mstump/iot_demo_hardware_v2/README.md

iot_demo_hardware_v2
====================
