mstump/iot_demo_hardware_v2/iot_inventory_mote/iot_inventory_mote.brd

## EAGLE design iot_inventory_mote/iot_inventory_mote.brd (2014-08-19)

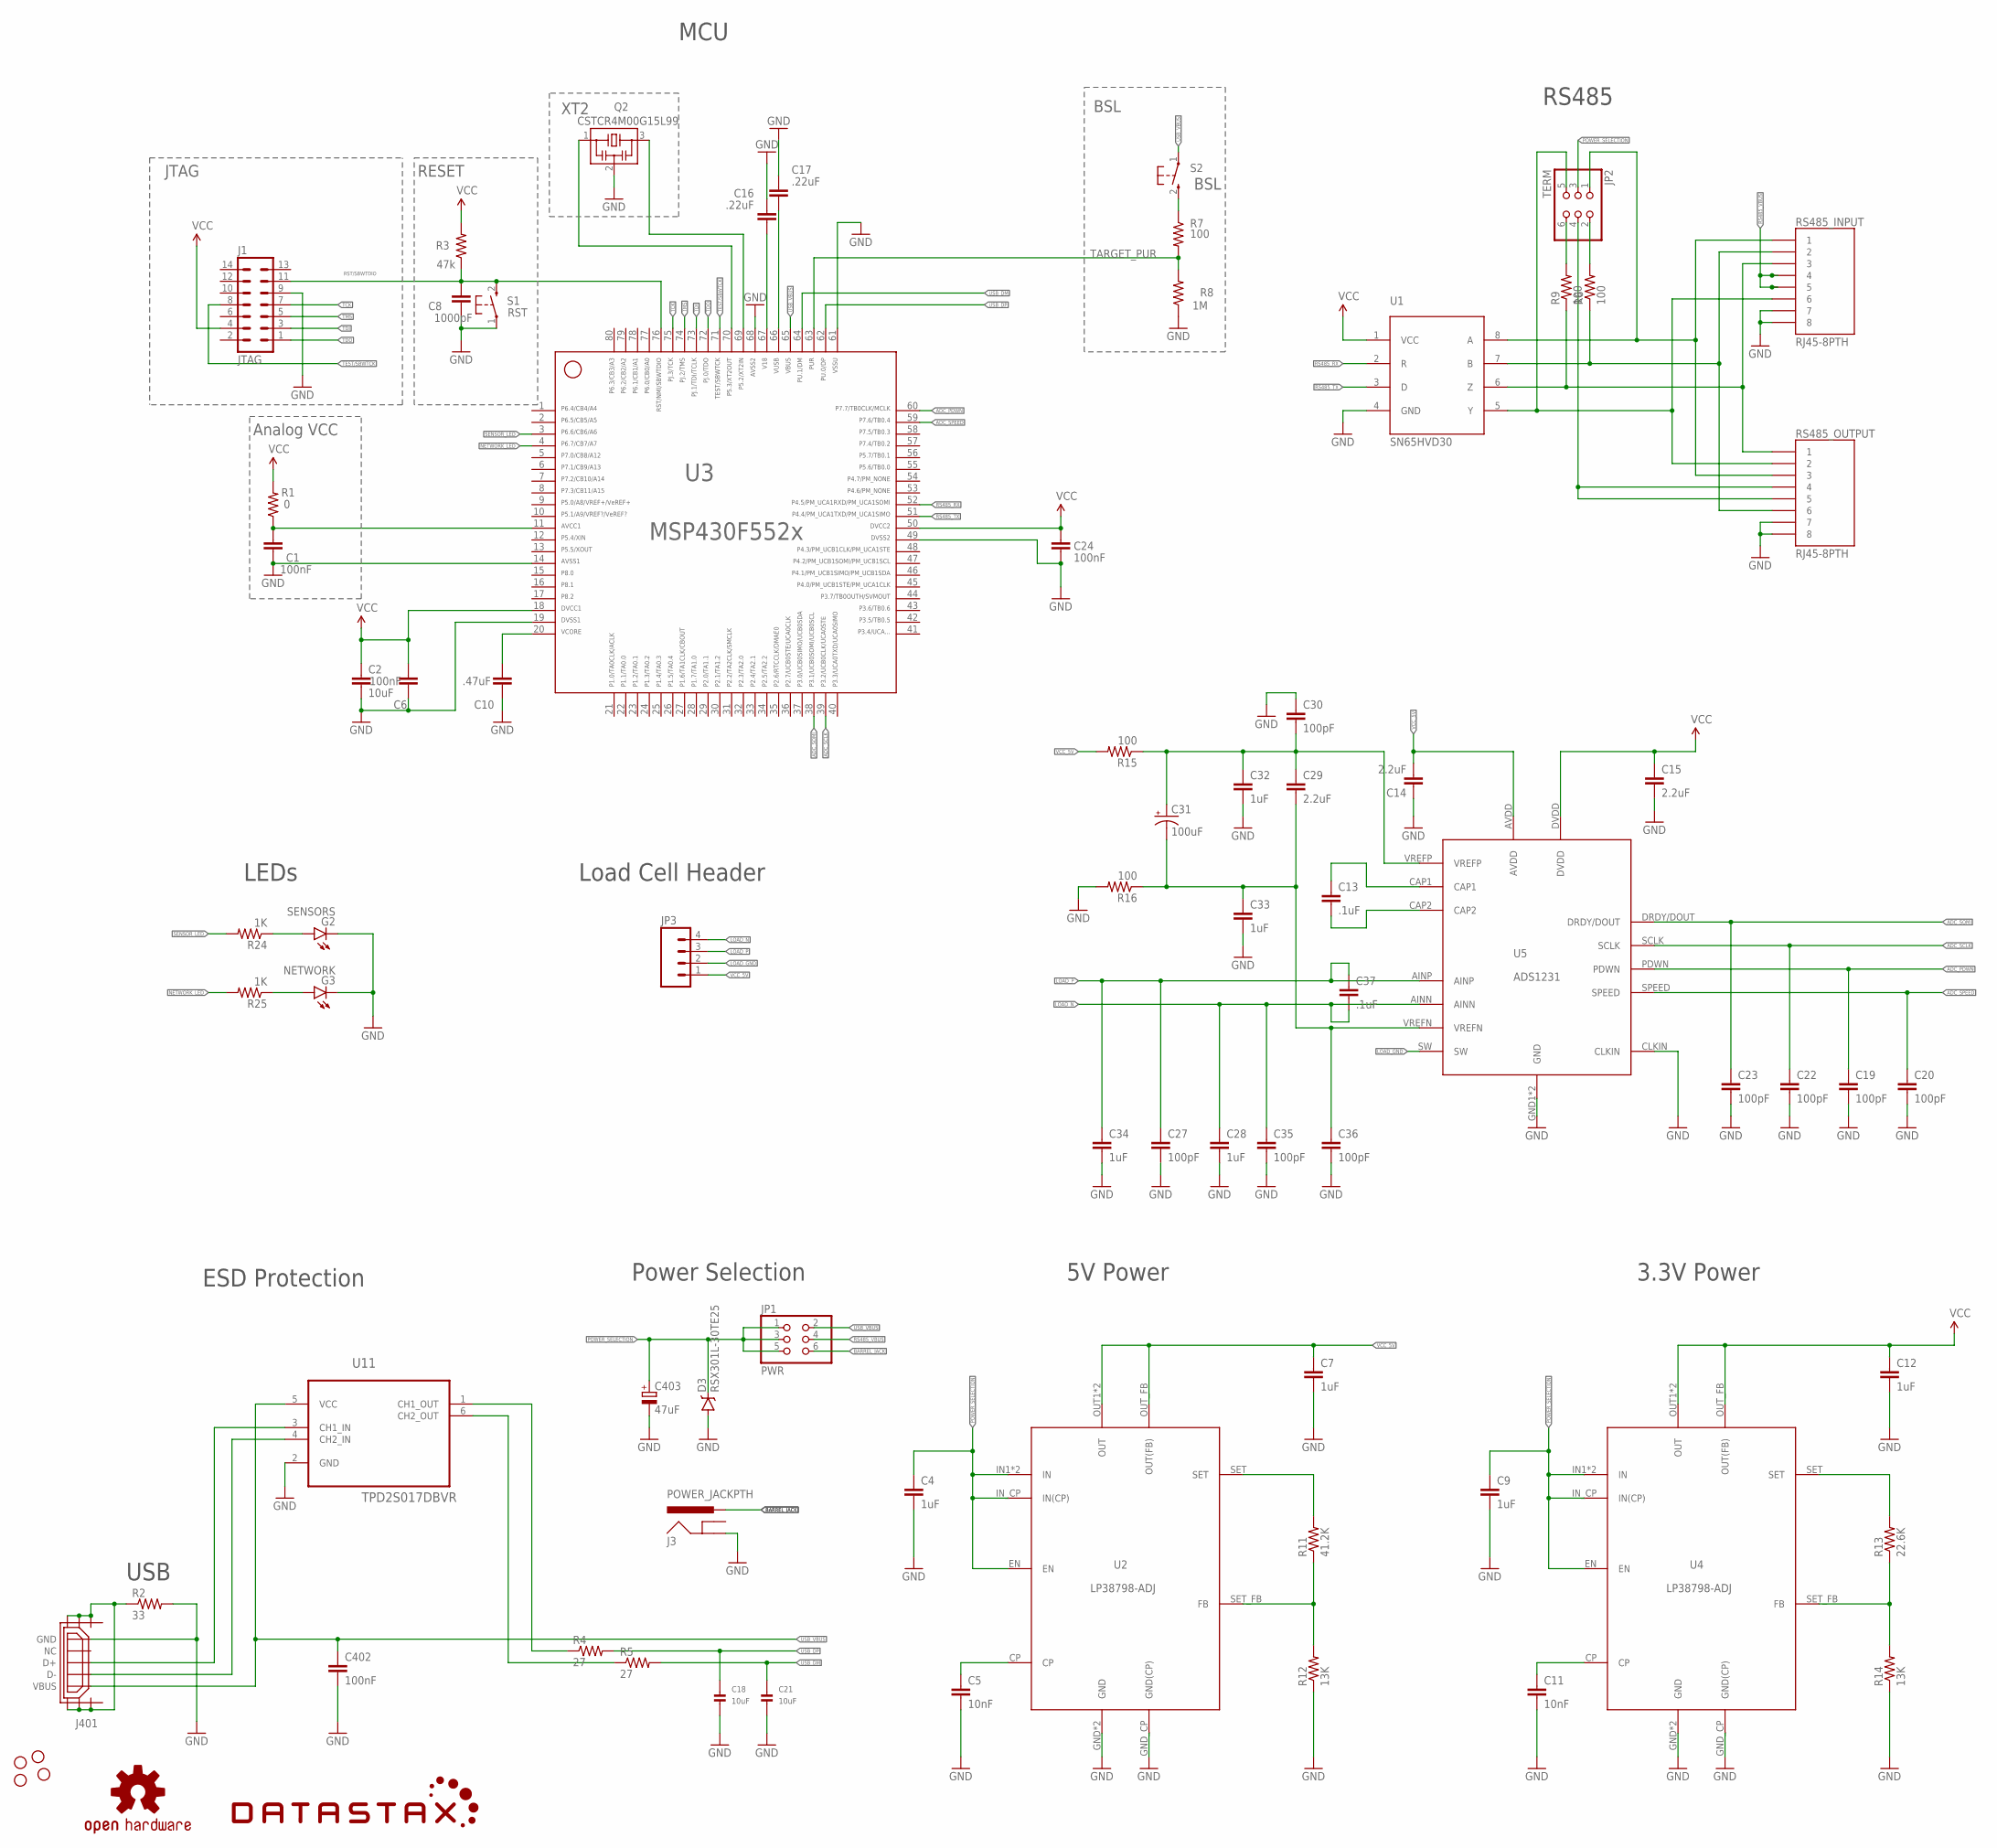
[picture p1: schematic iot_inventory_mote.sch, sheet 1]

Parts:
C1, C6, C24: 100nF; 0402-CAP
C2: 10uF; 0402-CAP
C4, C7, C9, C12: 1uF; 0402-CAP
C5, C11: 10nF; 0402-CAP
C8: 1000pF; 0402-CAP; MPN C1005X7R1H102K050BA
C10: .47uF; 0402-CAP
C13, C37: .1uF; 1210
C14, C15, C29: 2.2uF; 0402-CAP
C16, C17: .22uF; 0402-CAP
C18, C21: 10uF; 0603; MPN 06035A100FAT2A
C19, C20, C22, C23: 100pF; 0805
C27, C30, C35, C36: 100pF; 0603-CAP
C28, C32, C33, C34: 1uF; 0805
C31: 100uF; EIA7343
C402: 100nF; 0402-CAP; MPN 100NA100MEFC12.5X25
C403: 47uF; A/3216-18R
D3: RSX301L-30TE25; SMA-DIODE
G2: SENSORS; LED-0603
G3: NETWORK; LED-0603
J1: JTAG; ML14; MPN SBH11-PBPC-D07-ST-BK
J3: POWER_JACKPTH; POWER_JACK_PTH
J401: USB_MICRO_FLIPPED; HIROSE-ZX62R-B-5P; MPN ZX62R-B-5P
JP1: PWR; 2X03
JP2: TERM; 2X03
JP3: M04SCREW; SCREWTERMINAL-3.5MM-4
LOGO1: OSHW-LOGOL; OSHW-LOGO-L
Q2: CSTCR4M00G15L99; MURATA-FILTER_CSTCR
R1: 0; R0402
R2: 33; 0402-RES
R3: 47k; R0402; MPN ERJ-2RKF4702X
R4, R5: 27; 0402-RES
R6, R9, R15, R16: 100; 0402-RES
R7: 100; R0402
R8: 1M; R0402
R11: 41.2K; 0402-RES
R12, R14: 13K; 0402-RES
R13: 22.6K; 0402-RES
R24, R25: 1K; 0402-RES; MPN ERJ-2RKF1001X
RS485_INPUT, RS485_OUTPUT: RJ45-8PTH; RJ45-8; MPN 54602-908LF
S1: RST; PBTH; MPN EVQ-11L05R
S2: BSL; PBTH
STANDOFF1, STANDOFF2, STANDOFF3, STANDOFF4: STAND-OFF
U1: SN65HVD30; SOIC8; MPN SN65HVD3082EDR
U2, U4: LP38798-ADJ; WSON12; MPN LP38798SD-ADJ/NOPB
U3: MSP430F5529IPNR; PN80; MPN MSP430F5529IPNR
U5: ADS1231; MPN ADS1231ID
U11: TPD2S017DBVR; SOT95P280X145-6N
U$1: DATASTAX_LOGO

Connections:
ADC_PDWN: C19.1, U3.60, U5.PDWN
ADC_SCLK: C22.1, U3.39, U5.SCLK
ADC_SOMI: C23.1, U3.38, U5.DRDY/DOUT
ADC_SPEED: C20.1, U3.59, U5.SPEED
AVCC: C1.1, R1.1, U3.11
BARREL_JACK: J3.PWR, JP1.6
GND: C1.2, C2.2, C4.2, C5.2, C6.2, C7.2, C8.2, C9.2, C10.2, C11.2, C12.2, C14.1, C15.2, C16.2, C17.2, C18.2, C19.2, C20.2, C21.2, C22.2, C23.2, C24.2, C27.2, C28.2, C30.1, C32.2, C33.2, C34.2, C35.2, C36.2, C402.2, C403.-, D3.A, G2.C, G3.C, J1.9, J3.GND, J401.GND, Q2.2, R2.2, R8.1, R12.1, R14.1, R16.2, RS485_INPUT.7, RS485_INPUT.8, RS485_OUTPUT.7, RS485_OUTPUT.8, S1.1, U1.4 (GND), U2.GND, U2.GND_CP (GND(CP)), U2.GPAD (GND), U3.14, U3.19, U3.49, U3.61, U3.68, U4.GND, U4.GND_CP (GND(CP)), U4.GPAD (GND), U5.CLKIN, U5.GND1 (GND), U5.GND2 (GND), U11.2 (GND)
LOAD_GND: JP3.2, U5.SW
LOAD_N: C28.1, C35.1, C37.2, JP3.4, U5.AINN
LOAD_P: C27.1, C34.1, C37.1, JP3.3, U5.AINP
unnamed: JP2.2, R6.2
unnamed: R6.1, RS485_INPUT.2, RS485_OUTPUT.6, U1.7 (B)
unnamed: R9.1, RS485_INPUT.3, RS485_OUTPUT.1, U1.6 (Z)
unnamed: JP2.1, RS485_INPUT.1, RS485_OUTPUT.3, U1.8 (A)
unnamed: G3.A, R25.1
unnamed: JP2.6, R9.2
unnamed: JP2.5, RS485_INPUT.6, RS485_OUTPUT.2, U1.5 (Y)
unnamed: R13.2, U4.SET
unnamed: J401.D+, U11.3 (CH1_IN)
unnamed: R11.1, R12.2, U2.SET_FB (FB)
unnamed: R11.2, U2.SET
unnamed: C5.1, U2.CP
unnamed: J401.D-, U11.4 (CH2_IN)
unnamed: R13.1, R14.2, U4.SET_FB (FB)
unnamed: C11.1, U4.CP
unnamed: C13.1, U5.CAP1
unnamed: C13.2, U5.CAP2
unnamed: G2.A, R24.1
unnamed: J401.SHIELD1, J401.SHIELD2, J401.SHIELD3, J401.SHIELD4, J401.SHIELD5, J401.SHIELD6, R2.1
unnamed: C29.1, C30.2, C31.A (+), C32.1, R15.1, U5.VREFP
unnamed: R7.1, S2.2 (S)
unnamed: R5.1, U11.6 (CH2_OUT)
unnamed: R4.1, U11.1 (CH1_OUT)
unnamed: C29.2, C31.C (-), C33.1, C36.1, R16.1, U5.VREFN
unnamed: JP2.4, RS485_OUTPUT.4, RS485_OUTPUT.5
NETWORK_LED: R25.2, U3.4
P5.2/XT2IN: Q2.3, U3.69
P5.3/XT2OUT: Q2.1, U3.70
POWER_SELECTION: C4.1, C9.1, C403.+, D3.C, JP1.1, JP1.3, JP1.5, JP2.3, U2.EN, U2.IN1 (IN), U2.IN2 (IN), U2.IN_CP (IN(CP)), U4.EN, U4.IN1 (IN), U4.IN2 (IN), U4.IN_CP (IN(CP))
RS485_RX: U1.2 (R), U3.52
RS485_TX: U1.3 (D), U3.51
RS485_VBUS: JP1.4, RS485_INPUT.4, RS485_INPUT.5
RST/SBWTDIO: C8.1, J1.11, R3.1, S1.2 (S), U3.76
SENSOR_LED: R24.2, U3.3
TARGET_PUR: R7.2, R8.2, U3.63
TARGET_VUSB: C17.1, U3.66
TCK: J1.7, U3.75
TDI: J1.3, U3.73
TDO: J1.1, U3.72
TEST/SBWTCK: J1.8, U3.71
TMS: J1.5, U3.74
USB_DM: C21.1, R5.2, U3.64
USB_DP: C18.1, R4.2, U3.62
USB_VBUS: C402.1, J401.VBUS, JP1.2, S2.1, U3.65, U11.5 (VCC)
V18: C16.1, U3.67
VCC: C2.1, C6.1, C12.1, C15.1, C24.1, J1.4, R1.2, R3.2, U1.1 (VCC), U3.18, U3.50, U4.OUT1 (OUT), U4.OUT2 (OUT), U4.OUT_FB (OUT(FB)), U5.DVDD
VCC_5V: C7.1, C14.2, JP3.1, R15.2, U2.OUT1 (OUT), U2.OUT2 (OUT), U2.OUT_FB (OUT(FB)), U5.AVDD
VCORE: C10.1, U3.20

Notes on the sheet:
USB
ESD Protection
RESET
XT2
BSL
Analog VCC
MCU
5V Power
JTAG
LEDs
RS485
3.3V Power
Power Selection
Load Cell Header

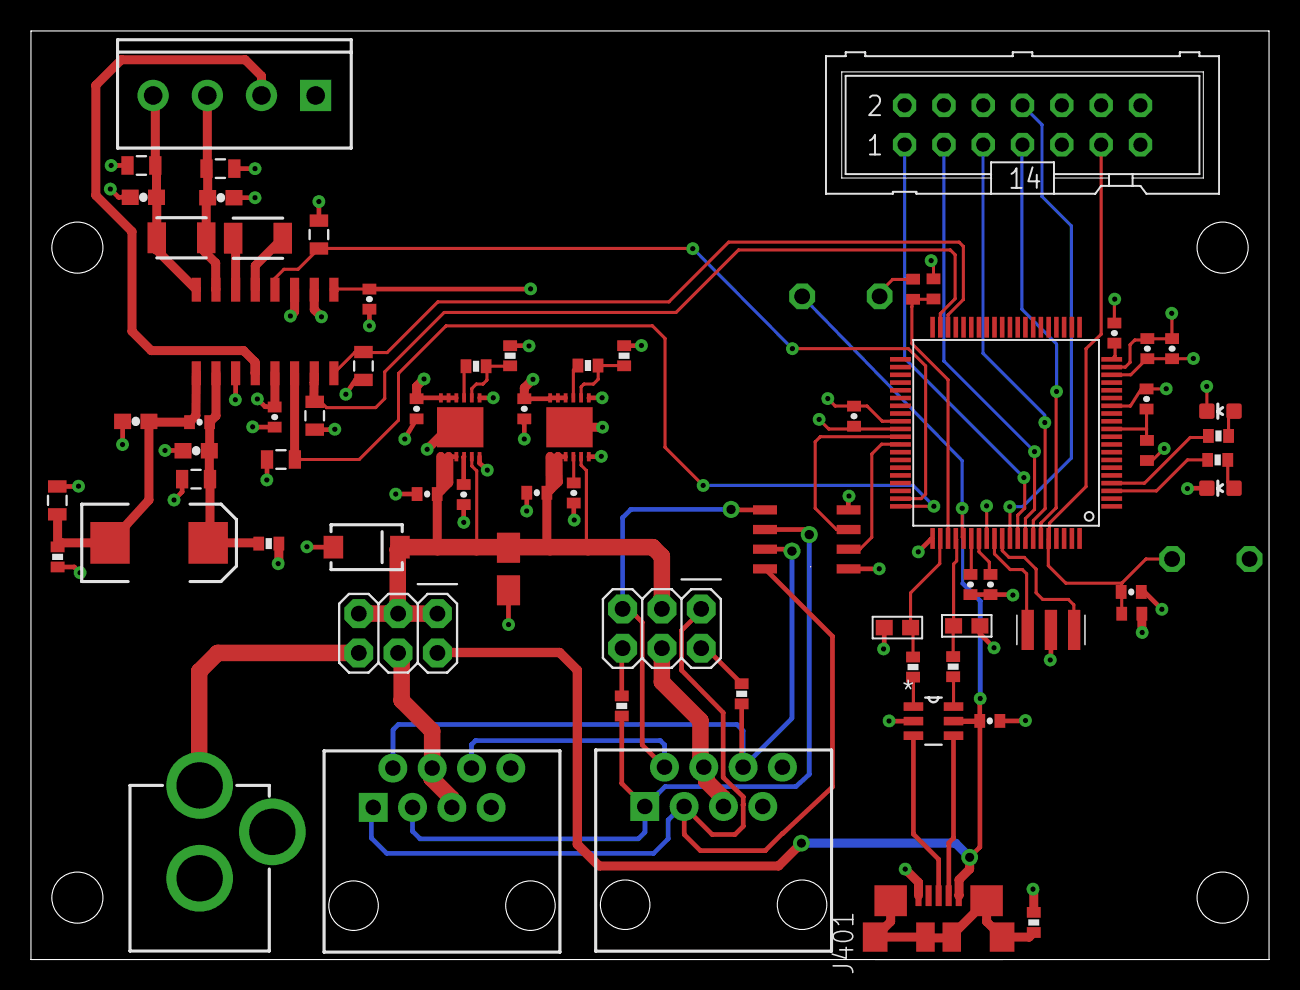
[picture p2: board iot_inventory_mote.brd from above]

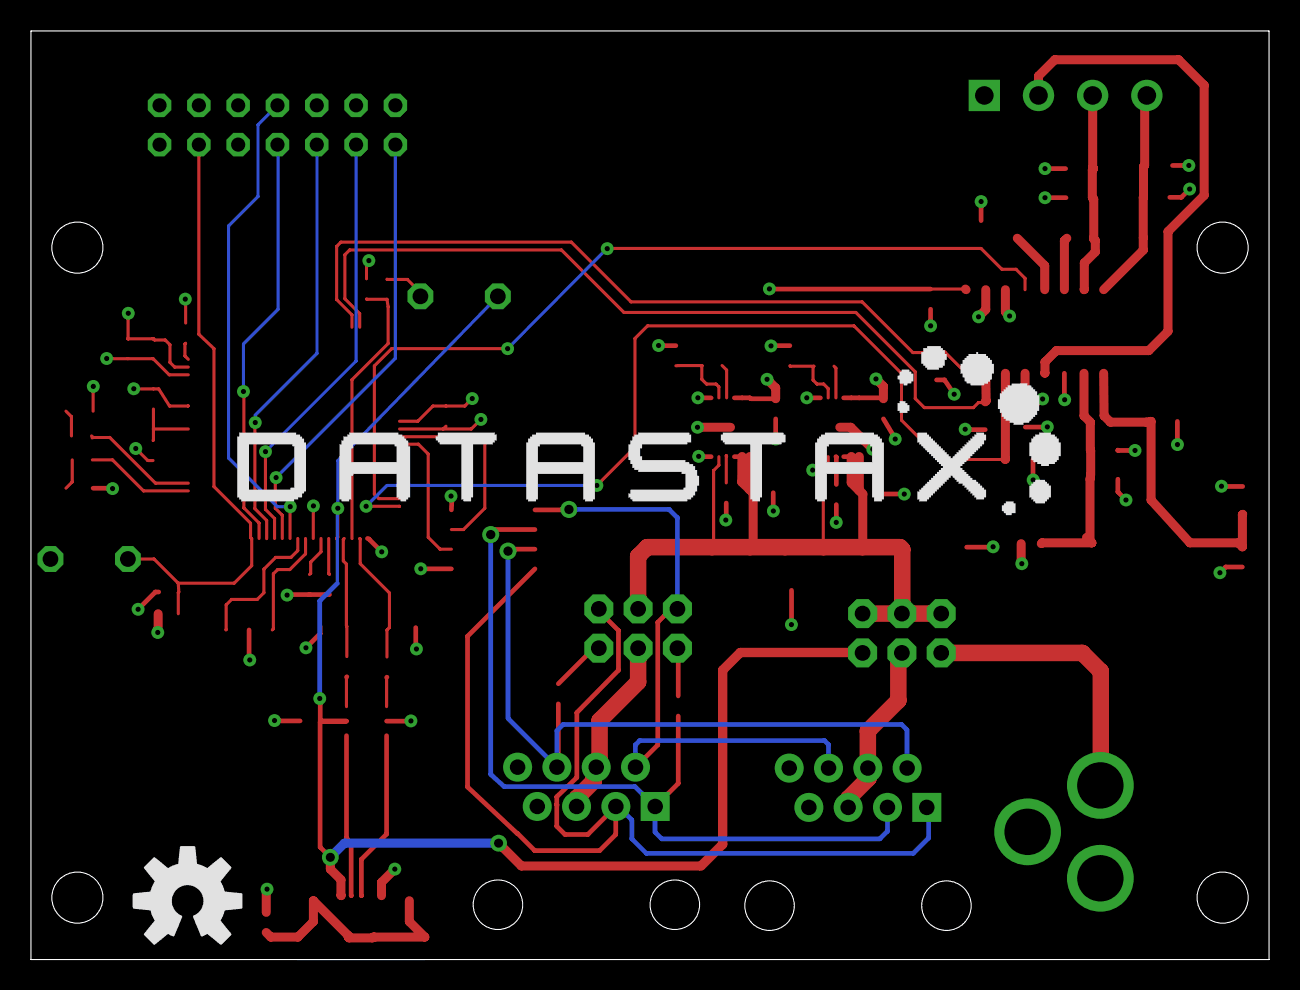
[picture p3: board iot_inventory_mote.brd from below]

Board: 4 copper layers, 80.0 x 60.0 mm, 79 parts (2 on the bottom side), 58 nets.
