mstump/iot_demo_hardware_v2/iot_env_mote/iot_env_mote.brd

## EAGLE design iot_env_mote/iot_env_mote.brd (2014-08-04)

Schematic: iot_env_mote.sch, sheet 1

Parts:
C1, C2, C6, C24: 100n; C0402
C3: 10u; A/3216-18R
C4, C12, C13: 10uF; 0805; MPN 06035A100FAT2A
C5: 2.2uF; 0805; MPN 06035A100FAT2A
C7, C11, C19, C31: 0.1uF; 0603; MPN 0603YC104JAT2A
C8: 1nF; C0402
C9, C18, C21: 10uF; 0603; MPN 06035A100FAT2A
C10: 470n; C0402
C16, C17: 220n; C0402
C22: 10uF; A/3216-18R
C23, C25: 1uF; 0603; MPN 06035A100FAT2A
C26, C27, C30, C33, C34, C38, C40, C42, C45, C48: 47nF; 0402-CAP; MPN 0603YC104JAT2A
C28, C32, C174: 15pF; 0402-CAP; MPN 0603YC104JAT2A
C29: 220nF; 0402-CAP; MPN 0603YC104JAT2A
C171: 10pF; 0402-CAP; MPN 0603YC104JAT2A
C172: 100pF; 0402-CAP; MPN 0603YC104JAT2A
C173: 33pF; 0402-CAP; MPN 0603YC104JAT2A
C175: 3pF; 0402-CAP; MPN 0603YC104JAT2A
C176: 1pF; 0402-CAP; MPN 0603YC104JAT2A
C181: 2.2pF; 0402-CAP; MPN 0603YC104JAT2A
C191, C201: 3.3pF; 0402-CAP; MPN 0603YC104JAT2A
C211: 10nF; 0402-CAP; MPN 0603YC104JAT2A
C221: 46nF; 0402-CAP; MPN 0603YC104JAT2A
C231: 1.5nF; 0402-CAP; MPN 0603YC104JAT2A
C402: 100nF; C0402
C403: 47uF; A/3216-18R
CHARGE: LED0603; LED-0603
CN1: USB; USB-MINIB
D8, D10: 0.01; R0402
D9: 1M; R0402
G1: SD/FLASH; LED-0603
G2: SENSORS; LED-0603
G3: NETWORK; LED-0603
J1: JTAG; ML14
J2: IO BREAKOUT; 2X10
J3: BATTERY; JST-PH-2-SMT-RA
JP2: MOTION; JST-3-PTH-VERT
L10: 4.7uH; SDR0403
L171: 10nH; C0402
L172: 7.5nH; C0402
L173: 18nH; C0402
L174, L192, L193, L201: 12nH; C0402
L191: 15nH; C0402
LOGO1: OSHW-LOGOL; OSHW-LOGO-L
POWER: LED0603; LED-0603
Q1: 32.768kHz; MS3V-T1R
Q2: CSTCR4M00G15L99; MURATA-FILTER_CSTCR
Q3: 40MHz; NX3225
Q4, Q5: BSS84; SOT23
R1: 0R; R0402
R2: 33k; 0402-RES
R3: 47k; R0402
R4, R5: 27; 0402-RES
R6, R27: 1K; R0402
R7: 100R; R0402
R8: 1M; R0402
R9, R18, R19, R20, R21, R23: 10K; R0402; MPN ERJ-P03F1002V
R10, R24, R25: 1K; 0402-RES
R12: 56k; 0402-RES
R16: 332K; R0402
R17: 649K; R0402
R26: 1.87K; R0402
R171: 10; 0402-RES
R181: 0; 0402-RES
S1: RST; PBTH
S2: BSL; PBTH
S3: DPDT; AYZ0202
SMA: SMA_EDGE; SMA-EDGE
U1: LTC3553-2; QFN-20-0.4MM
U2: MPL3115A2LGA8; LGA8; MPN MPL3115A2
U3: MSP430F5529IPNR; PN80
U4: HTU21DSMD; HTU21D; MPN HTU21D
U5: USD-SOCKETNEW; MICRO-SD-SOCKET-PP
U6: BQ27411; VSON40P400X400X12
U7: TSL2561FN; FN-6; MPN TSL2561T
U8: CC1200; RHB32
U11: TPD2S017DBVR; SOT95P280X145-6N
U$1: DATASTAX_LOGO

Connections:
AVCC: C1.1, R1.1, U3.11
BQ27411_BAT: C25.2, D8.2, J3.1 (2), U6.BAT, U6.SRP
FLASH_CD: U3.30, U5.CD1 (SHIELD)
FLASH_CSN: U3.29, U5.2 (CS)
FLASH_ENABLE: Q5.1 (G), U3.17
GND: C1.2, C2.1, C3.-, C4.2, C5.2, C6.1, C7.2, C8.2, C9.2, C10.1, C11.2, C13.2, C16.2, C17.2, C18.2, C19.2, C21.2, C22.-, C23.2, C24.2, C25.1, C26.2, C27.2, C28.2, C29.2, C30.2, C31.2, C32.2, C33.2, C34.2, C38.2, C40.2, C42.2, C45.2, C48.2, C171.2, C172.2, C175.2, C201.2, C211.2, C402.2, C403.-, D9.2, D10.2, J1.9, J2.2, J3.2 (1), JP2.1, L192.2, Q1.P3 (GND), Q2.2, Q3.2 (G2), Q3.4 (G1), R2.2, R8.1, R10.1, R12.2, R17.2, R24.1, R25.1, R26.1, R27.1, S1.1, SMA.GND@0 (GND), SMA.GND@1 (GND), SMA.GND@2 (GND), SMA.GND@3 (GND), U1.2 (SEQ), U1.5 (LDO_ON), U1.6 (STBY), U1.15 (NTC), U1.19 (SUSP), U1.21 (GND_PAD), U2.3 (GND), U3.14, U3.19, U3.49, U3.61, U3.68, U4.7 (GND), U4.GND, U5.6 (GND), U5.GND1 (SHIELD), U5.GND3 (SHIELD), U6.GND (TPAD), U6.VSS, U7.2 (ADDR), U7.3 (GND), U8.TP (33), U11.2 (GND)
I2C_SCL: J2.4, R18.1, R21.1, U2.8 (SCL), U3.47, U4.SCK, U6.SCL, U7.4 (SCL)
I2C_SDA: J2.6, R19.1, R20.1, U2.7 (SDA), U3.46, U4.DATA, U6.SDA, U7.6 (SDA)
IO_LED: G1.A, U3.26
IO_SCK: U3.36, U5.5 (SCK)
IO_SIMO: U3.40, U5.3 (DI)
IO_SOMI: U3.41, U5.7 (DO)
JTAG_SENSE: J1.4, S3.5
JTAG_VCC: J1.2, S3.3
LDO: U1.10 (LDO)
LDO_FB: U1.9 (LDO_FB)
LIGHT_INT: R9.1, U3.58, U7.5 (INT)
MOTION_ENABLE: Q4.1 (G), U3.59
MOTION_INT: JP2.2, U3.60
unnamed: C11.1, U2.2 (CAP)
unnamed: JP2.3, Q4.2 (S)
unnamed: C174.1, L171.1, U8.17
unnamed: Q5.2 (S), U5.4 (VCC), U5.8 (RSV)
unnamed: C231.2, U8.23
unnamed: CN1.D+, U11.3 (CH1_IN)
unnamed: C23.1, U6.VDD
unnamed: D10.1, U6.TEST
unnamed: C231.1, U8.24
unnamed: CN1.D-, U11.4 (CH2_IN)
unnamed: D9.1, U6.PROG
unnamed: C211.1, U8.21
unnamed: C174.2, C176.1, L172.1
unnamed: C29.1, U8.6
unnamed: C176.2, C181.2, L172.2, L173.1
unnamed: L174.2, R181.1
unnamed: C181.1, L193.2, U8.18
unnamed: C221.2, U8.22
unnamed: R181.2, SMA.SIG (SIGNAL)
unnamed: C175.1, L173.2, L174.1
unnamed: CN1.GND, R2.1
unnamed: C173.2, L171.2, R171.1
unnamed: C28.1, Q3.1 (X1), U8.30
unnamed: C191.1, L191.1, L192.1, U8.19
unnamed: C201.1, L191.2, L201.1, U8.20
unnamed: C32.1, Q3.3 (X2), U8.31
unnamed: G1.C, R10.2
unnamed: C191.2, L193.1, L201.2
unnamed: L10.2, U1.13 (SW)
unnamed: R12.1, U8.14
unnamed: R7.1, S2.2 (S)
unnamed: G2.C, R24.2
unnamed: G3.C, R25.2
unnamed: R5.1, U11.6 (CH2_OUT)
unnamed: R4.1, U11.1 (CH1_OUT)
unnamed: CHARGE.C, R6.1
unnamed: C4.1, C5.1, CHARGE.A, POWER.A, U1.12 (BVIN), U1.18 (VOUT)
unnamed: R6.2, U1.14 (CHRG)
unnamed: POWER.C, R27.2
unnamed: C12.2, R16.1, R17.1, U1.8 (BUCK_FB)
unnamed: R26.2, U1.16 (PROG)
P1.0: J2.20, U3.21
P1.1: J2.17, U3.22
P1.2: J2.18, U3.23
P1.3: J2.15, U3.24
P1.4: J2.16, U3.25
P2.2: J2.13, U3.31
P2.3: J2.14, U3.32
P2.4: J2.11, U3.33
P2.5: J2.12, U3.34
P2.6: J2.9, U3.35
P5.2/XT2IN: Q2.3, U3.69
P5.3/XT2OUT: Q2.1, U3.70
P5.4/XIN: Q1.P2 (2), U3.12
P5.5/XOUT: Q1.P1 (1), U3.13
PRESSURE_INT: R23.1, U2.6 (INT1), U3.43
REGULATOR_BUCK_ON: U1.7 (BUCK_ON), U3.2
REGULATOR_HPWR: U1.1 (HPWR), U3.1
REGULATOR_VCC: C12.1, C13.1, L10.1, R16.2, S3.1, S3.4
RF_CLK: U3.39, U8.8
RF_CSN: U3.53, U8.11
RF_GPIO0: U3.54, U8.10
RF_GPIO2: U3.55, U8.4
RF_GPIO3: U3.56, U8.3
RF_LED: G3.A, U3.28
RF_RESET: U3.57, U8.2
RF_SIMO: U3.37, U8.7
RF_SOMI: U3.38, U8.9
RST/SBWTDIO: C8.1, J1.11, R3.1, S1.2 (S), U3.76
SENSOR_LED: G2.A, U3.27
TARGET_PUR: R7.2, R8.2, U3.63
TARGET_VUSB: C17.1, U3.66
TCK: J1.7, U3.75
TDI: J1.3, U3.73
TDO: J1.1, U3.72
TEST/SBWTCK: J1.8, U3.71
TMS: J1.5, U3.74
UCA1_CLK: J2.10, U3.45
UCA1_RXD: J2.3, U3.52
UCA1_STE: J2.8, U3.48
UCA1_TXD: J2.5, U3.51
USB_DM: C21.1, R5.2, U3.64
USB_DP: C18.1, R4.2, U3.62
USB_VBUS: C402.1, C403.+, CN1.VBUS, J2.19, S2.1, U1.20 (VBUS), U3.65, U11.5 (VCC)
V18: C16.1, U3.67
VBAT+: D8.1, U1.17 (BAT), U6.SRN
VCC: C2.2, C3.+, C6.2, C7.1, C9.1, C19.1, C22.+, C24.1, C26.1, C27.1, C30.1, C31.1, C33.1, C34.1, C38.1, C40.1, C42.1, C45.1, C48.1, C171.1, C172.1, C173.1, C221.1, J2.1, Q4.3 (D), Q5.3 (D), R1.2, R3.2, R9.2, R18.2, R19.2, R20.2, R21.2, R23.2, R171.2, S3.2, U2.1 (VDD), U2.4 (VDDIO), U3.18, U3.50, U4.VDD, U7.1 (VDD), U8.1, U8.5, U8.12, U8.13, U8.15, U8.25, U8.26, U8.27, U8.28, U8.29
VCORE: C10.2, U3.20
VINLDO: U1.11 (VINLDO)

Notes on the sheet:
Humidity
Pressure
Sensors
I2C address is 0x40 I2C write is 0x80 I2C read is 0x81
I2C address is 0x60 I2C write is 0xC0 I2C read is 0xC1
Light
I2C address is 0x41
Battery Charger / Regulator
Battery Gauge
USB
ESD Protection
Radio
RESET
LFXTCLK
XT2
BSL
Analog VCC
MCU
Power Selection
JTAG
IO Breakout
MicroSD Flash
LEDs

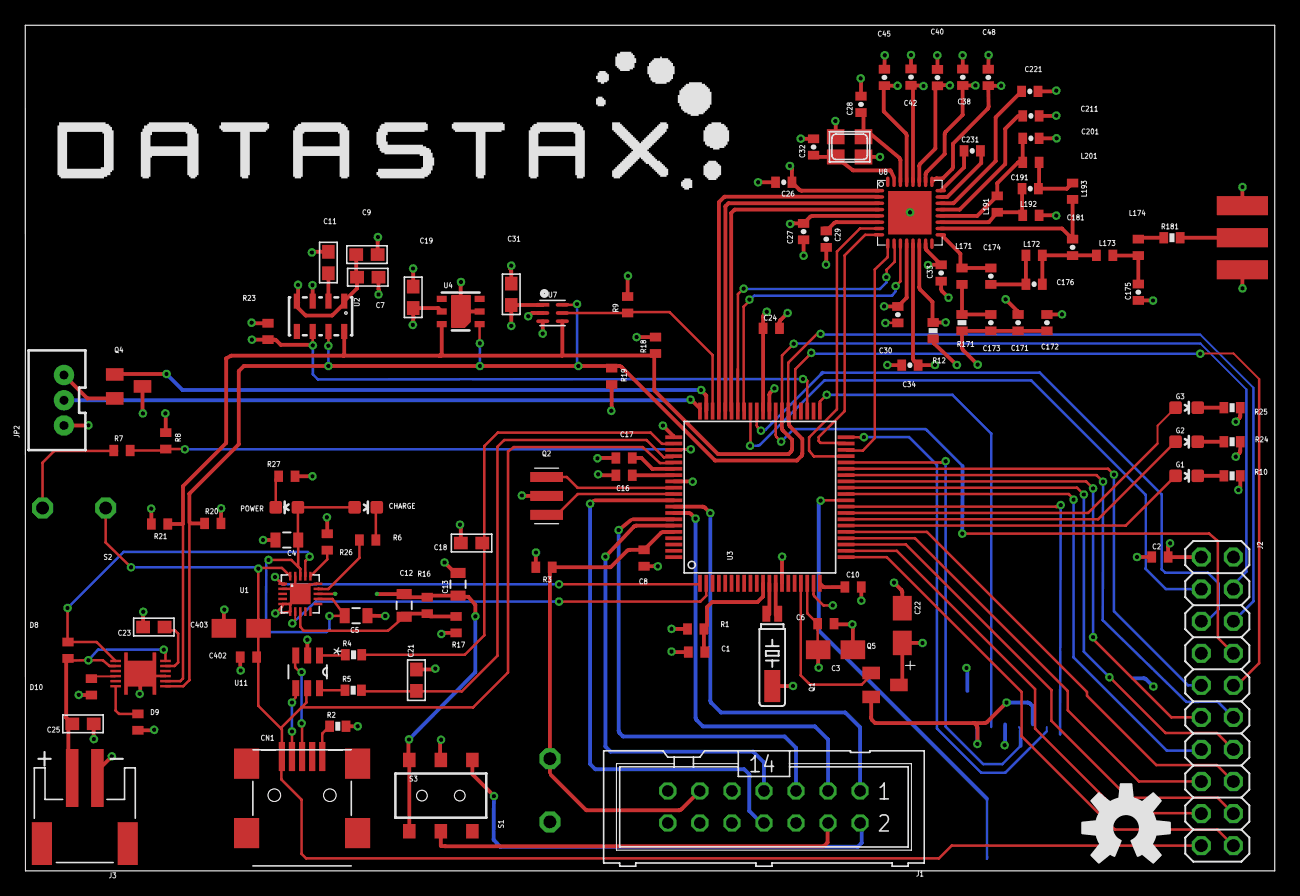
[picture p4: board iot_env_mote.brd from above]

Board: 4 copper layers, 99.0 x 67.0 mm, 116 parts (1 on the bottom side), 105 nets.
