mstump/iot_demo_hardware_v2/(commit log)

2014-07-25 everything except the MCU
    [iot_demo_mote.brd, iot_demo_mote.sch]
2014-07-28 flash, jtag, and spi
    [iot_demo_mote.brd, iot_demo_mote.sch]
2014-07-28 schematic is functionally done
    [iot_demo_mote.brd, iot_demo_mote.sch]
2014-07-28 added datastax and open hardware logos
    [iot_demo_mote.brd, iot_demo_mote.sch]
2014-07-28 rename to make room for the scale mote
    [iot_env_mote.brd, iot_env_mote.sch]
2014-08-03 mostly routed
    [iot_env_mote.brd, iot_env_mote.sch]
2014-08-05 final env board layout
    [iot_inventory_mote.brd, iot_inventory_mote.sch]
2014-08-17 final inventory board
    [iot_inventory_mote.brd, iot_inventory_mote.sch]
2014-08-19 increased annular ring, order placed
    [iot_inventory_mote.brd]
